ITstreet1/WHITEBoard-DevKit-C/MicroPython examples/readme.md

Neopixel in MicroPython works only with ver 1.17

https://micropython.org/download/esp32c3/
