ITstreet1/WHITEBoard-DevKit-C/Diagram.png

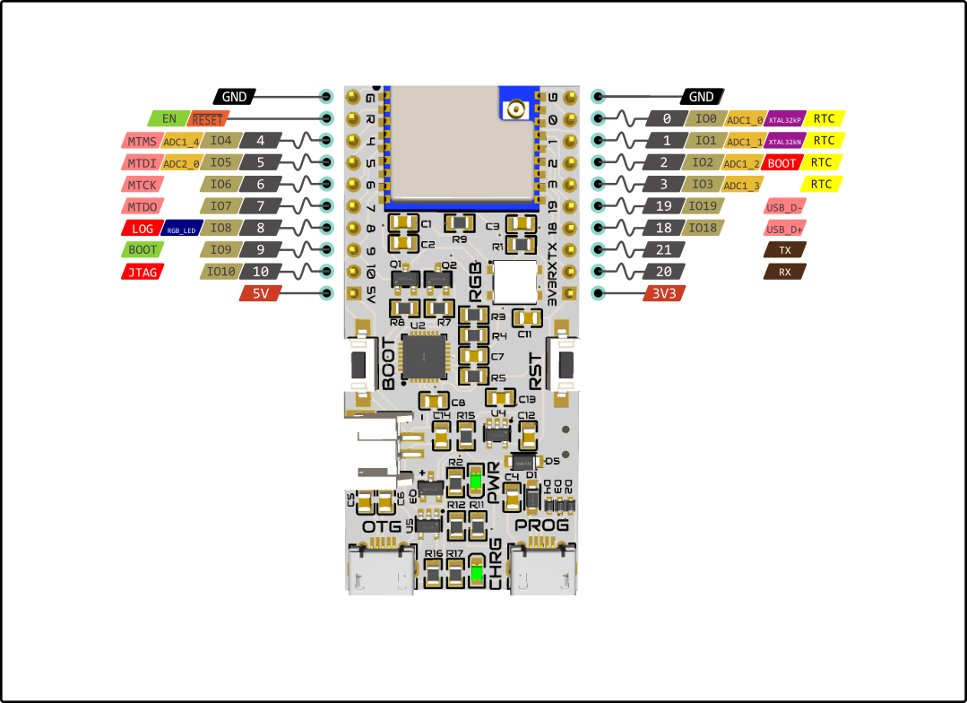
Diagram.png
