ITstreet1/WHITEBoard-DevKit-C/PCB Files/Schematic_WHITEBoard DevKitC_2021-12-14.png

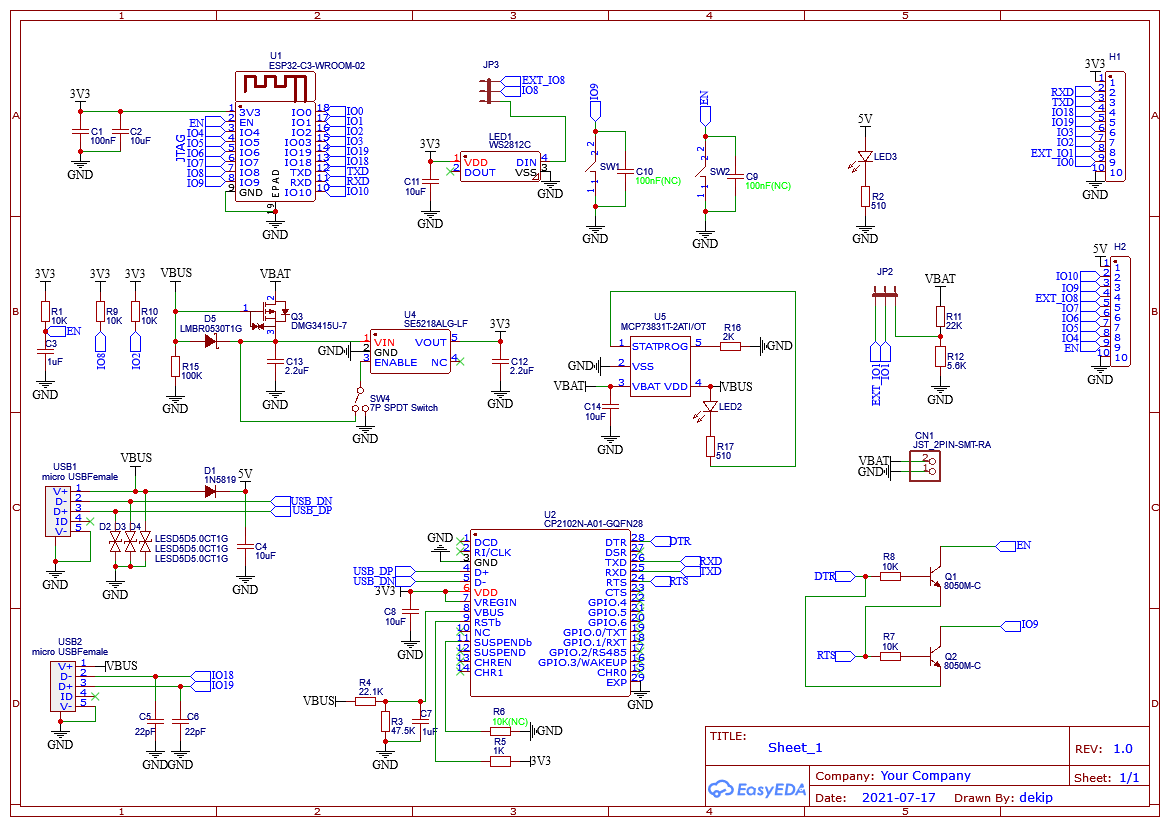
PCB Files/Schematic_WHITEBoard DevKitC_2021-12-14.png
